tysecgh/easyspinning/note.pdf

# 簡易木製スピニングリール制作について

### 平成 38 年 11 月 9 日

## 1 初めに

この文章を通読する必要はない. 写真だけ, 　設計図だけ見て作り始めるの も可. 試行錯誤もまた工作の楽しみの一つである.

### 1.1 先に言っておきたいこと

1. 制作過程を楽しむ (楽しめる) ことがわりあい大切.
2. 市販品の性能を求めては落胆する. ロマンを重視しよう.

※余談になるが, リールをできるだけ安く手に入れたいという方向に効率 を求める場合は釣り人の知人を作ることを勧める. 趣味人というものは, まだ まだ使える道具があっても, つい新しいものに手を出してしまいがちで, 性能 も状態も十分な道具を余らせがちなものである.

### 1.2 「簡易」木製スピニングリールとは

設計するにあたって「スピニングリール」を回転するアームと, 竿と平行 に固定された糸巻を持ち, 次の機構を持っているものととらえている.

1. 糸を回転するアームに引っ掛けて, 糸巻に巻きつけることによって巻き 取る.
2. アームから糸を外すことにより, 糸の自由放出 (とそれを利用した仕掛 けの投擲) が可能.

制作難度の調整結果としてペールやオシレーション機構, ドラグ機構等は省略 している.

1. ペールの省略:糸の引っ掛けが手動なのでもたつく→がんばれ
2. オシレーション機構の省略:糸絡みの可能性の増大→そんなにヘビーに 使うもんではない
3. ドラグ機構の省略:ロマンが減る→ロマン成分は自作に求める

1

## 2 制作

### 2.1 材料

1. 100mm x 100mm x 6mm MDF 板, 4 枚（DAISO で 6 枚組で売ってる）
2. 丸箸 (コンビニ等で弁当とかに付けてくれるやつ) (約 6mmm 径の丸棒)
3. 竹串 (約 3mmm 径の丸棒)
4. 木工ボンド
5. 瞬間接着剤

2～5 も家のどっかになければ 100 均でも入手可. 2，5 はそれっぽい棒で用意 したドリル刃の径と適合してれば何でも代用可.
実際に遣うためには以下も必要
1. 巻くための釣り糸 (ナイロン糸で十分)
2. 竿取付用金具 (適当な大きさのステー等で代用可, 何なら竿も自作して ねじ止めしても良し)

### 2.2 道具

1. のこぎり
2. 平彫刻刀あるいは小さなノミ（C2 部材の溝切り落としに使うだけ）
3. ラチェットドライバーとドリル刃 (6mm と 2.8mm, 丸箸と竹串の直径に 大体あってるもの. 多少いい加減でも良いが太い方は緩く細い方はきつ めの方が都合良い.)
4. コンパスと定規, 筆記具
5. (木工) やすり

あると便利な道具

1. マスキングテープ（仮固定用）
2. クランプ（固定, 圧着用）
3. 丸やすり（穴径の調整）
4. 垂直穴あけ用のジグ
5. ホビーカンナ (円に削るときとか早くなる)
6. 止型定規（線引きに何かと便利）

2

### 2.3 作り方

最重要部分は A パーツ B パーツの 2 つの歯車部分で, 特に歯の部分の (穴 位置) 精度が重要なのでそこだけは気を付けること. 逆を言えばそれ以外の部 分は多少適当でも動く.

### 2.3.1 部材の切り出し

円はのこぎりで大雑把に丸くした後, やすりなどで丸くする. 実を言えば機 械機構としての円の作成を要求する部位はない (丸棒の丸とドリル穴の丸を 使っている) のでそこまで頑張って丸くしなくても良い. A2B1D1 が丸いの は他の部材との干渉を避けるためであり, D2D3 が丸いのは糸の出をスムーズ にする為であるのでこれらをクリアする程度の円でよい.
一方で, C123 の長辺の直線, C2 切り込みの長辺に対する直交性は機械機構 として必要な要素. 長辺は切り出し前の直線を生かせると楽. 切り込みは丁 寧に切ること.

### 2.3.2 組み立て

1. 設計図に従って ABCD 各パーツを組む.
- 基本木工ボンドで圧着
- A パーツ B パーツの歯の根元に最後に瞬間接着剤をたらして強度 を上げる
- A3 パーツの糸の「入り口」はヤスリで削って少し広げておいた方 が使い易い.
2. A パーツに D パーツを挿し, A パーツが回転できるようにしながら D パーツを C パーツに固定する. D パーツは回転してはいけない.(引き抜 く方向に力がかかるのでそれに抗するように固定)
3. 適当な長さに切った丸箸を B パーツと C パーツに通し, 回転可能な様 に箸の両端を止める.

各パーツどうしの固定は接着しない木釘 (というか竹串釘) を用いるなど取り 外し可能な様にできればその方が使い勝手が良い.

3
