tysecgh/easyspinning/EasySpinning.pdf

# CADB

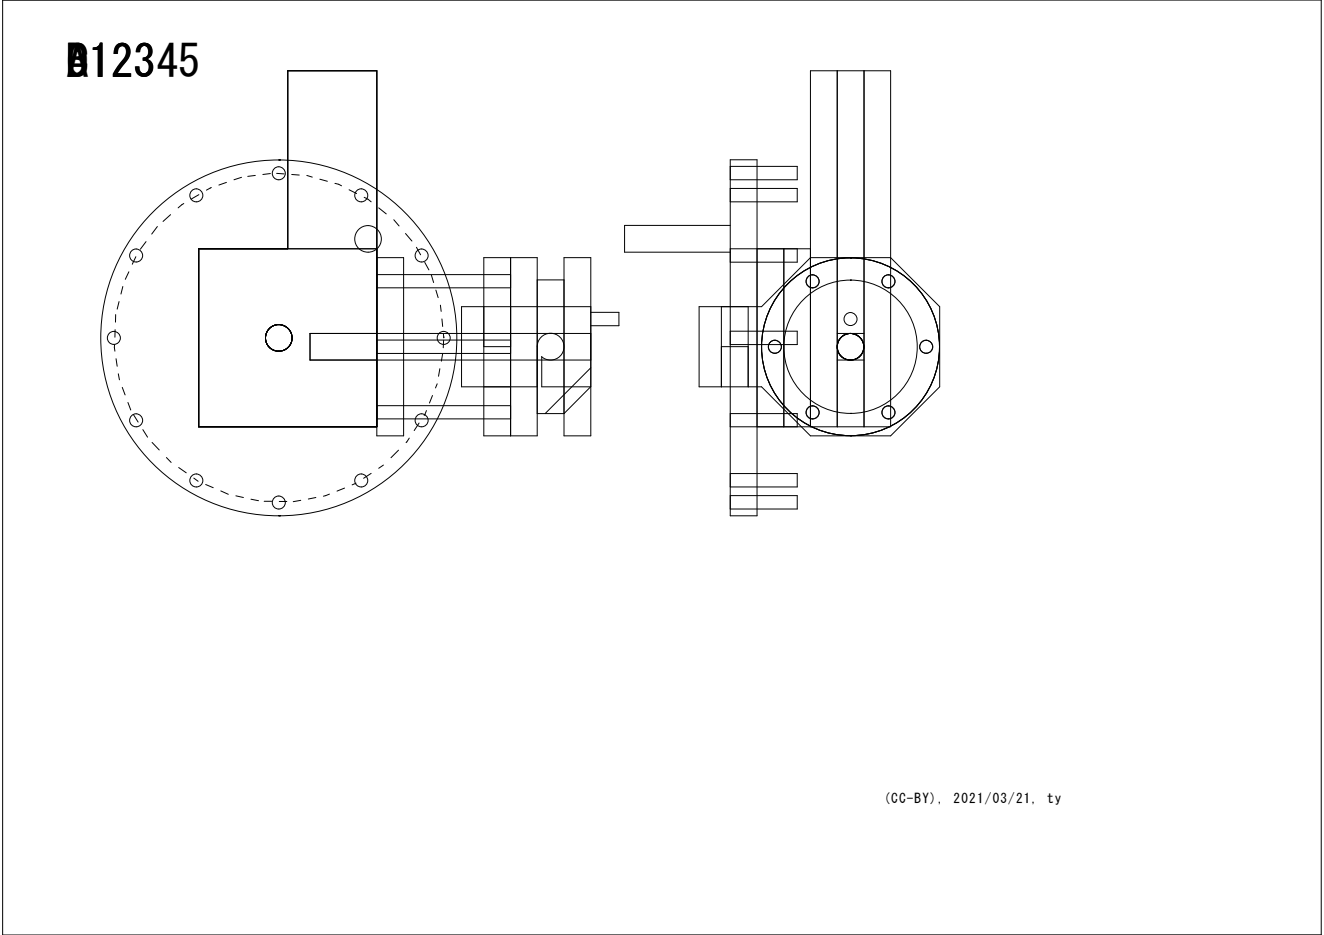
[picture p1: page 1]

A

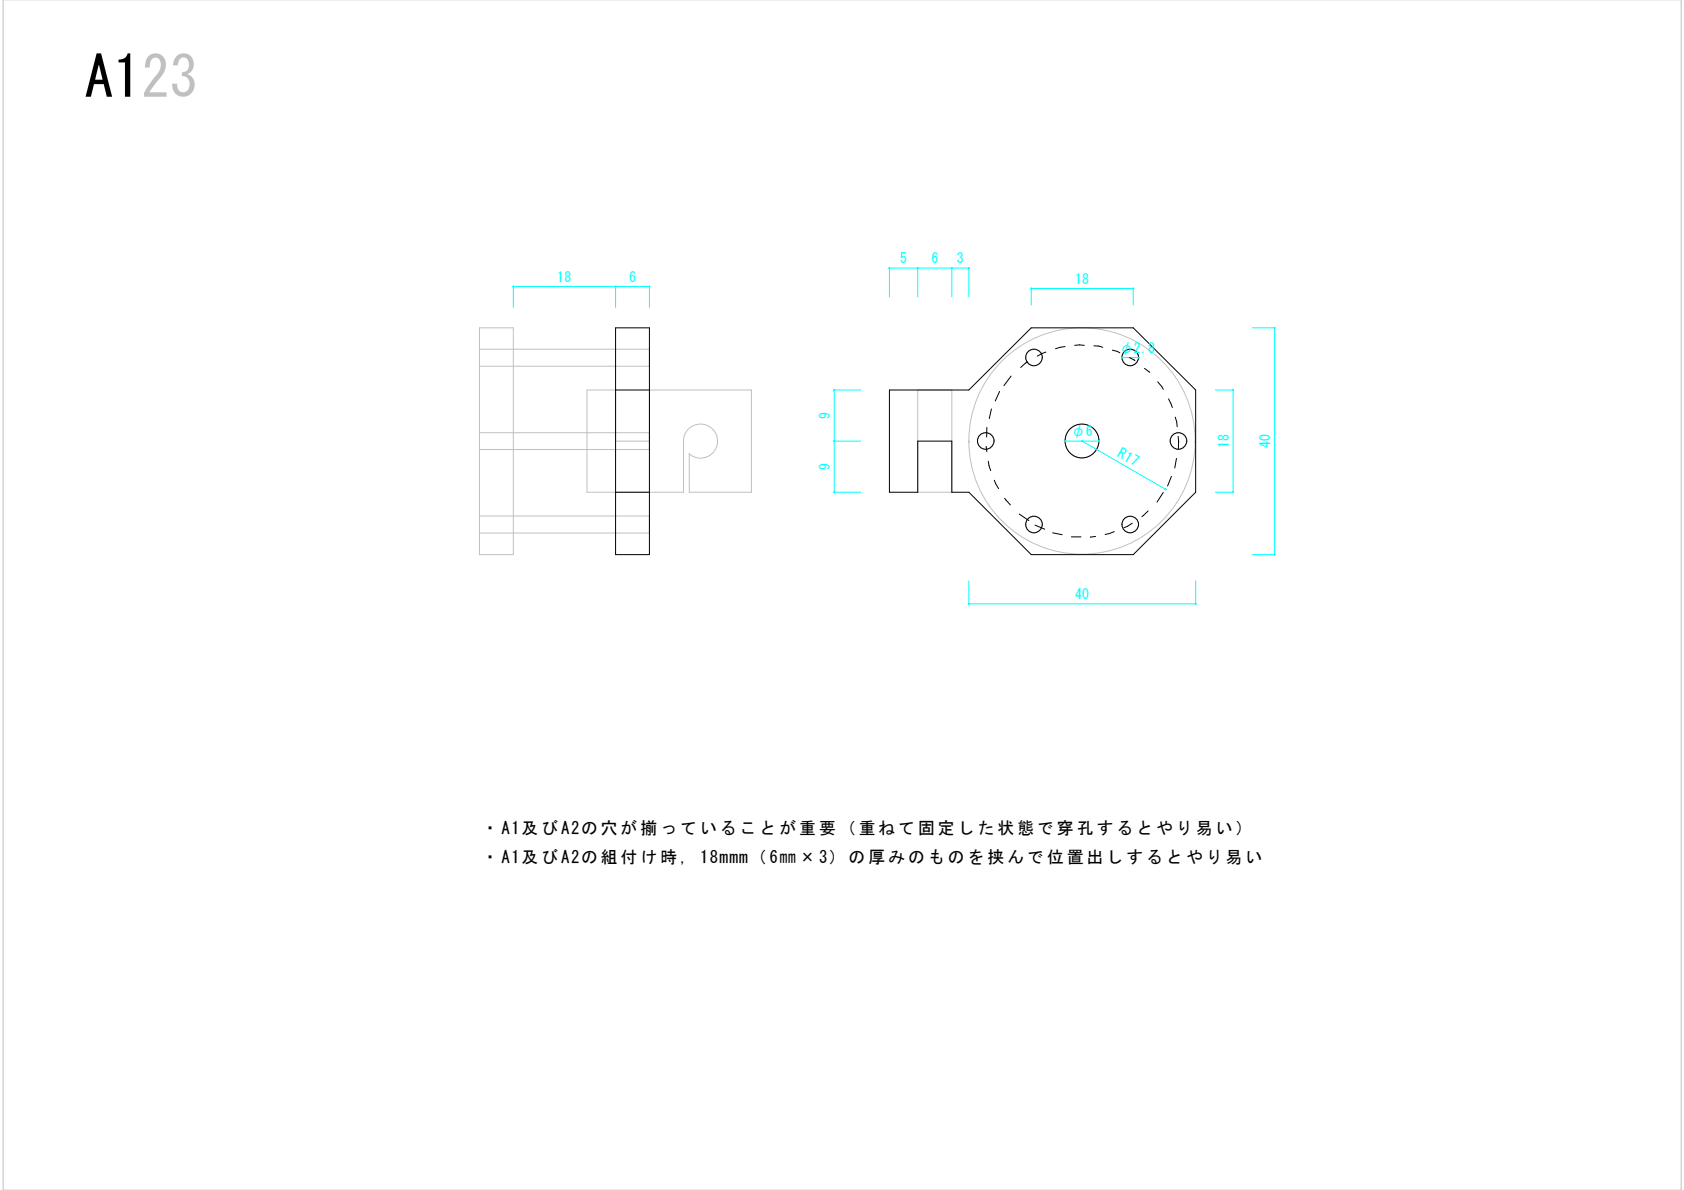
[picture p2: page 2]
18 mmm（ 6㎜ × 3） の 厚 み の も の を 挟 ん で 位 置 出 し す る と や り 易 い

1 32

R20

6

A

5 | 6 | 9 | 9
11 | 6 | 12

9

9

6

・ 糸 を か け る 穴 の 「 高 さ 」 以 外 は 自 由 に ア レ ン ジ 可

A

B

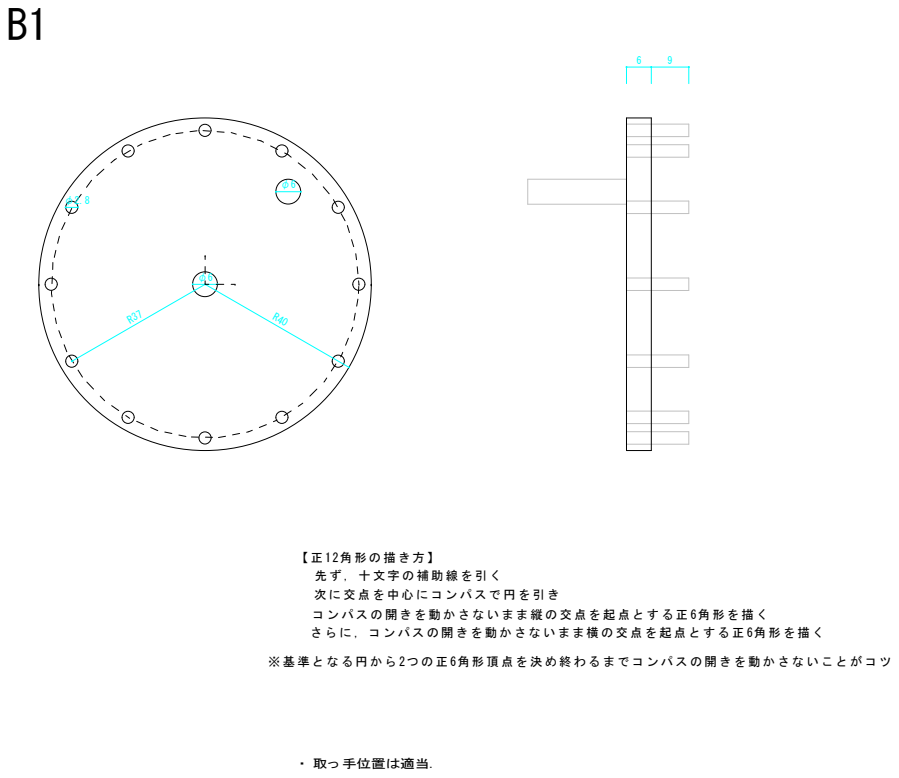
[picture p3: page 5]
取っ 手位置は適当.

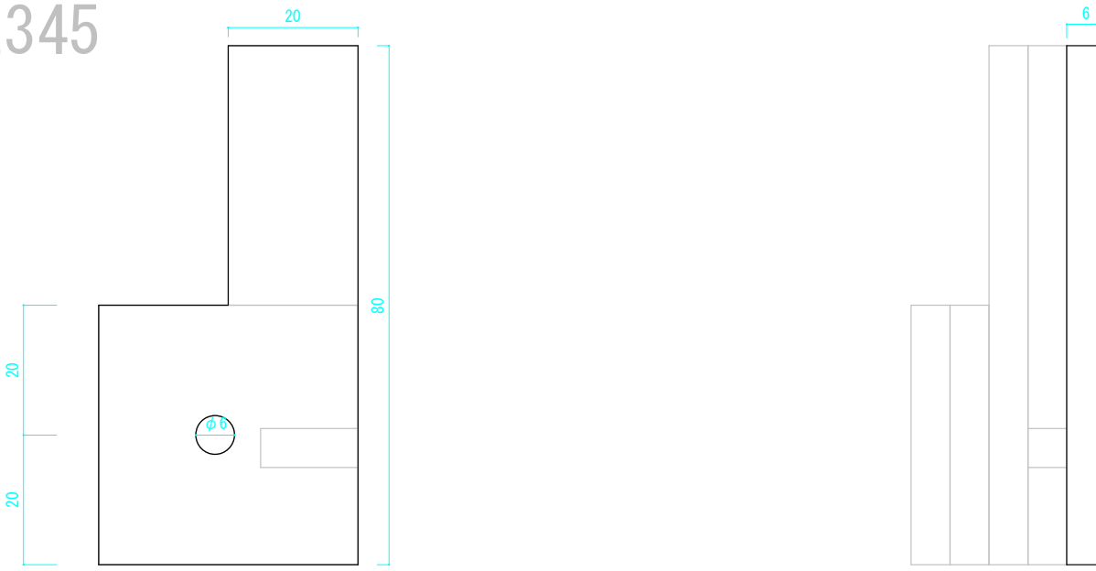
[picture p4: figure]

22

40

・ 右 側 面 は 回 転 す る Bパ ー ツ と の 接 地 面 に な る の で 平 ら に

・ φ 6の 穴 は Cを 全 て 組 ん で か ら 穿 孔 す る と ズ レ な い

・ φ 6の 穴 と 右 側 面 か ら の 距 離 が す れ る と 干 渉 の 可 能 性 が あ る

C

1 345 2

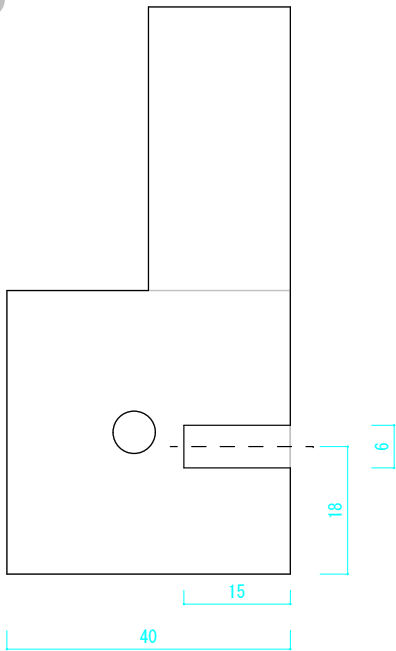
[picture p5: figure]

40

・ 穴 の 中 心 と 右 の 溝 の 中 心 は 2 mmず し て い る

C

C12 45 3

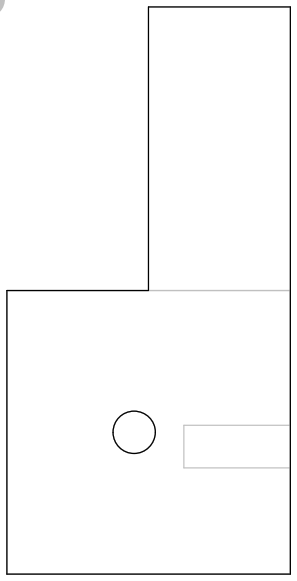
[picture p6: figure]

123 54

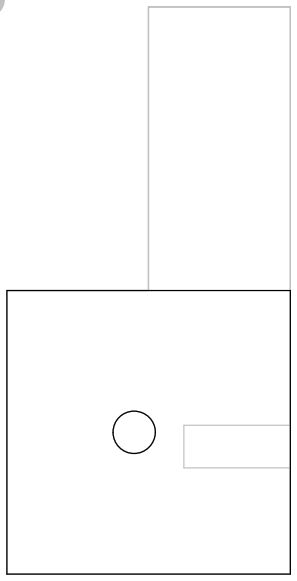
[picture p7: figure]

・ 左 手 で ハ ン ド ル を 回 す 場 合 は C4 C5を 逆 側 に 組 み 付 け る

C

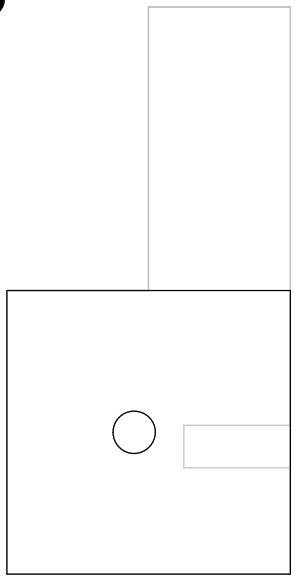
[picture p8: figure]

・ 左 手 で ハ ン ド ル を 回 す 場 合 は C4 C5を 逆 側 に 組 み 付 け る

C

R20

φ6

6

・ 組 ん だ 後 に 糸 の 開 始 点 を 通 す 穴 を あ け , 糸 の 端 を ひ っ か け る 棒 を 立 て る

D

1 32

6

R15

D

D123
