tysecgh/easyspinning/newprj/txt/animationCO.gif

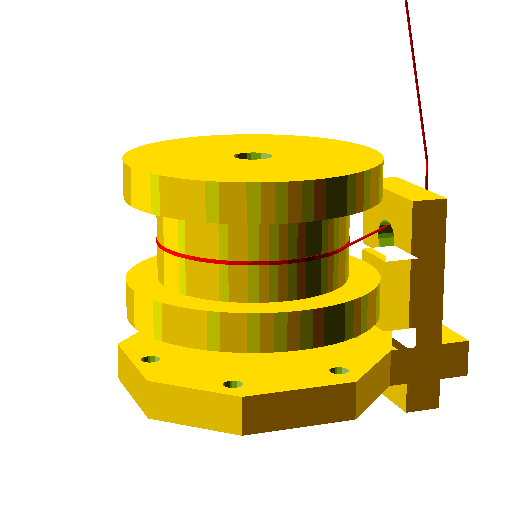
newprj/txt/animationCO.gif
