tysecgh/easyspinning/newprj/txt/animationOC.gif

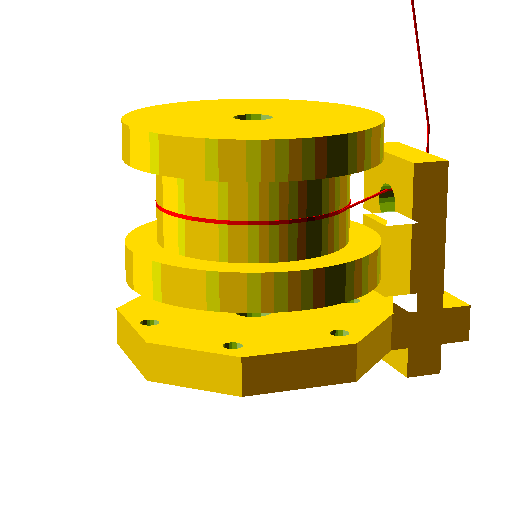
newprj/txt/animationOC.gif
