tysecgh/easyspinning/newprj/txt/force.png

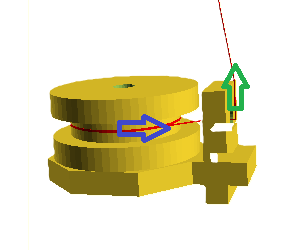
newprj/txt/force.png
