tysecgh/easyspinning/newprj/txt/新しいフォルダー/0.png

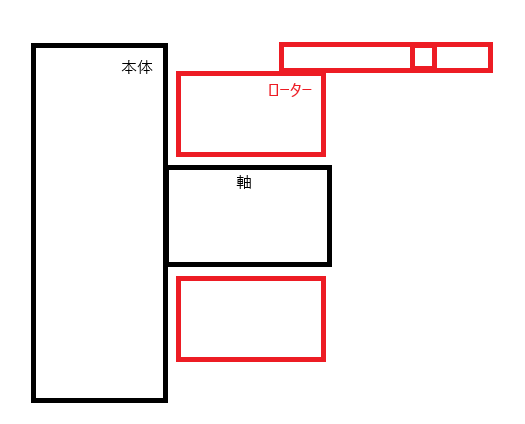
newprj/txt/新しいフォルダー/0.png
