tysecgh/easyspinning/newprj/txt/新しいフォルダー/2.png

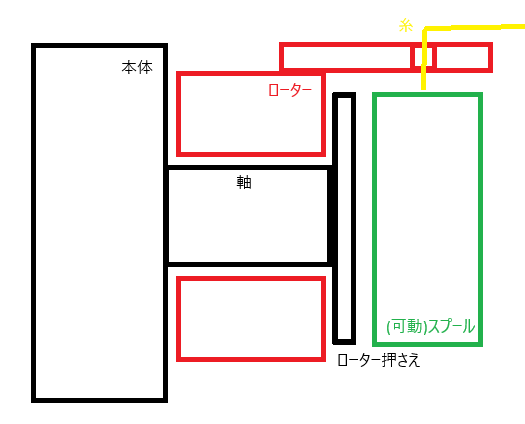
newprj/txt/新しいフォルダー/2.png
