tysecgh/easyspinning/newprj/txt/新しいフォルダー/3.png

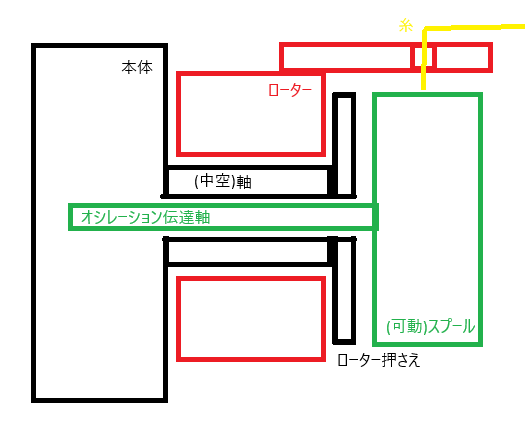
newprj/txt/新しいフォルダー/3.png
