tysecgh/easyspinning/newprj/txt/新しいフォルダー/4.png

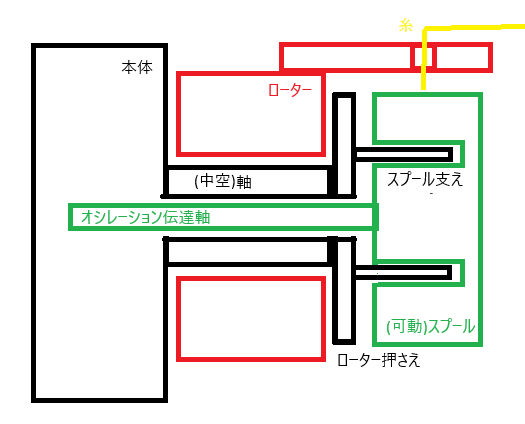
newprj/txt/新しいフォルダー/4.png
