tysecgh/easyspinning/newprj/VIEW/housyutu.gif

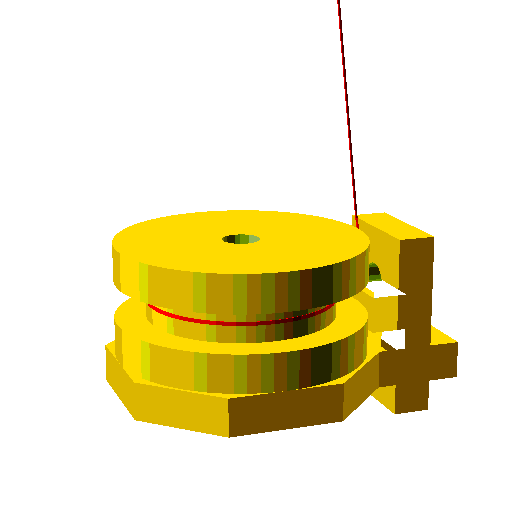
newprj/VIEW/housyutu.gif
