tysecgh/easyspinning/newprj/VIEW/makitori.gif

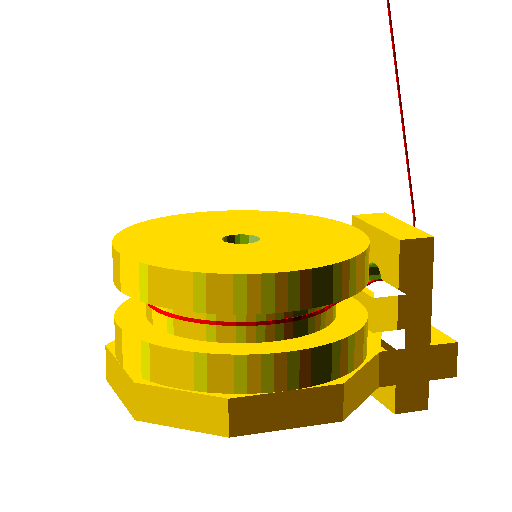
newprj/VIEW/makitori.gif
