tysecgh/easyspinning/newprj/VIEW/withline.scad

include <../main.scad>

$time = 4;

VIEW_WITHLINE($time);
