tysecgh/easyspinning/newprj/VIEW/withline2.scad

include <../main.scad>

$time = 0;

translate([0,0,-52])
rotate([0,-90,0])
VIEW_WITHLINE2($time);
