tysecgh/easyspinning/newprj/VIEW/withOc.scad

include <../main.scad>

$time = 6;

VIEW_WITHCO($time);
