tysecgh/easyspinning/jww/EasySpinningB.pdf

1

B

取っ 手位置は適当.
